Tamk1s/SSM/Common Rsrsc/SetupPics/CRT.jpg

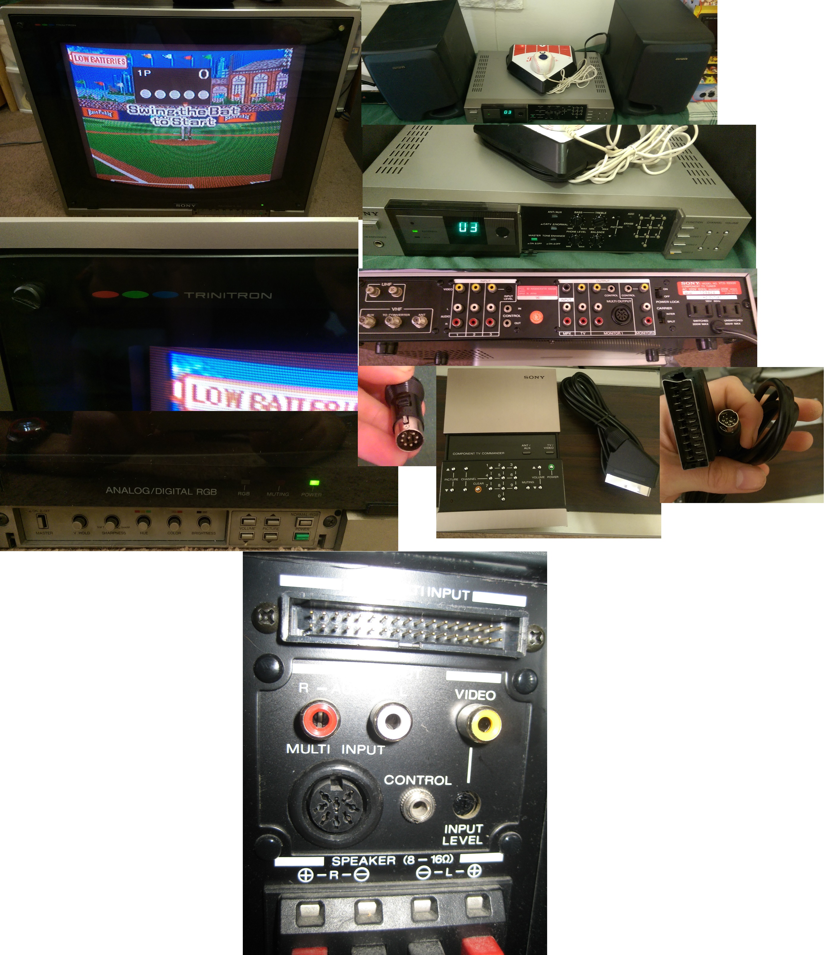
Common Rsrsc/SetupPics/CRT.jpg
