Tamk1s/SSM/SSMX_RGB/Resources/switcher_diagram_engadget_howto.jpg

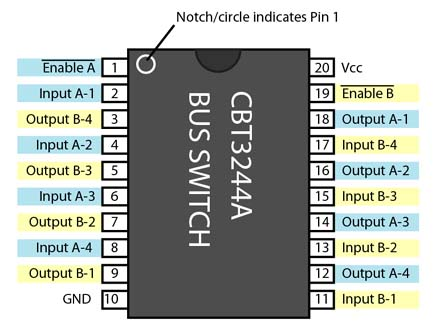
SSMX_RGB/Resources/switcher_diagram_engadget_howto.jpg
