Tamk1s/SSM/Common Rsrsc/Links.txt

Basic info about RGB - http://retrorgb.com/rgbintro.html

Base schematic info:
SCART -> IDC34 = https://wavebeam.blogspot.com/2017/08/making-scart-adapter-for-sony-34-pin.html
BNC -> IDC34 = https://www.reddit.com/r/crtgaming/comments/85gxof/sony_profeel_34_pin_rgb_cable_success/dw0ljwp/ and https://imgur.com/gallery/XTBUQ
S-Video -> SCART = https://pinouts.ru/Audio-Video-Hardware/scart_adapter_pinout.shtml
S-Video pinout = https://what-when-how.com/display-interfaces/standards-for-analog-video-part-i-television-display-interfaces-part-3/

Schematic info:

Bus Switcher - https://www.engadget.com/2007/03/13/how-to-make-a-solid-state-a-v-switcher/
Bus Switcher 2 - https://forums.overclockers.com.au/threads/solid-state-av-switcher.608891/
SCART Breakout - https://oshpark.com/shared_projects/X2S30KLq

Pullup Resistor info - https://learn.sparkfun.com/tutorials/pull-up-resistors

Eagle Symbols:
IDC34 - http://www.diymodules.org/eagle-show-library?type=usr&id=1012211566&part=con-3m-skt-header.lbr
SCART - https://www.diymodules.org/eagle-show-object?type=std&file=con-hirschmann.lbr&device=SCART-F
Switches - https://github.com/zumbik/Eagle-Libraries/blob/master/gm/gm-switches.lbr
DC Jack symbol pins - https://electronics.stackexchange.com/questions/2381/deciphering-a-dc-jack-schematic
