Tamk1s/SSM/Artwork/geagle.png

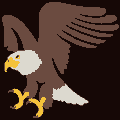
Artwork/geagle.png
