Tamk1s/SSM/Artwork/Large/p0m.bmp

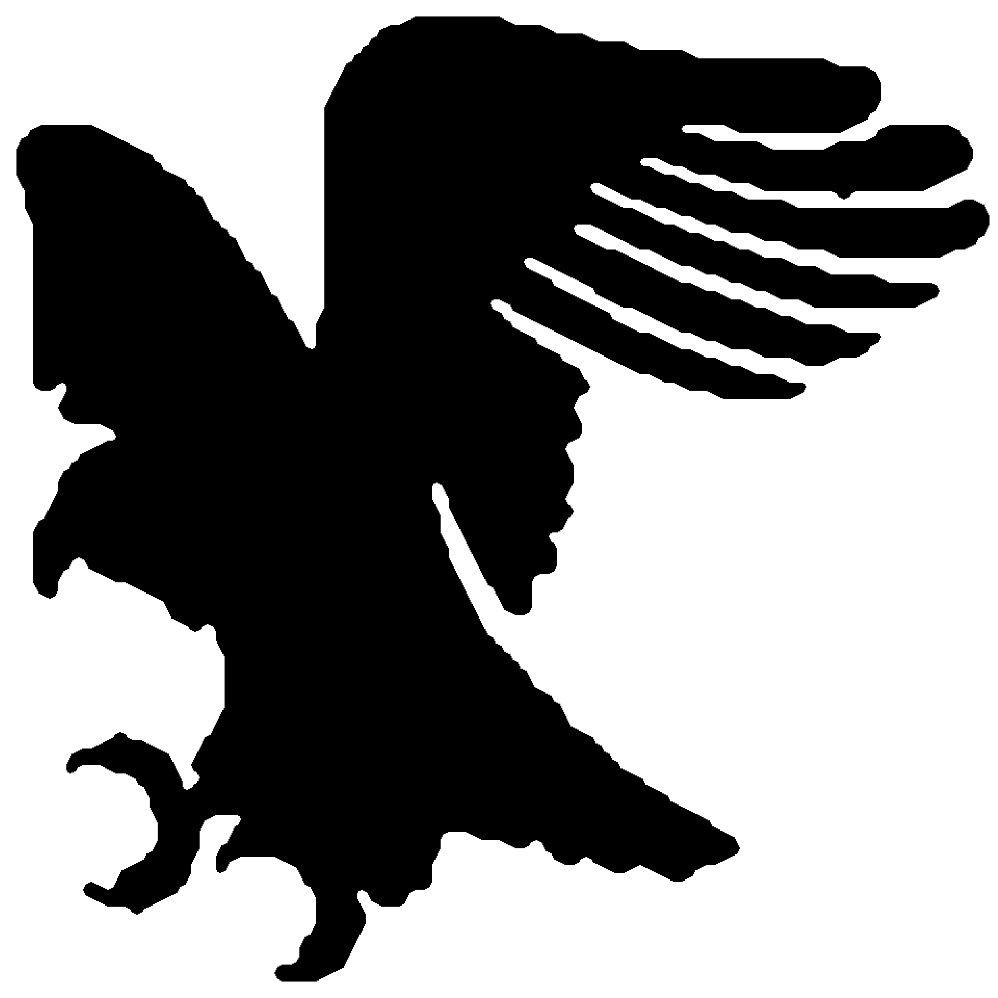
Artwork/Large/p0m.bmp
