Tamk1s/SSM/Artwork/Large/p1m.bmp

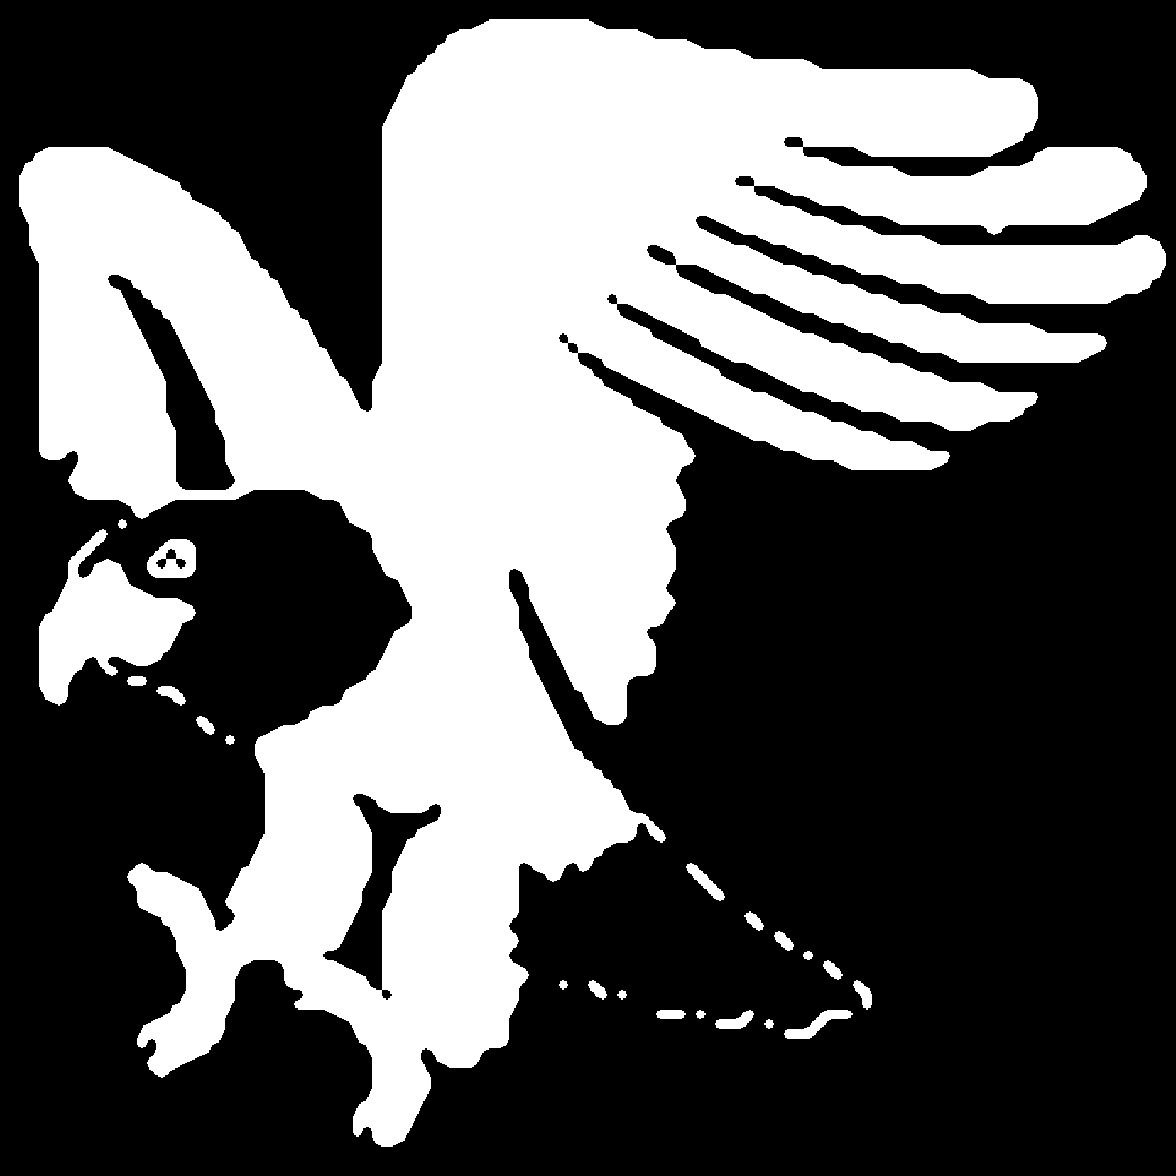
Artwork/Large/p1m.bmp
