Tamk1s/SSM/Artwork/Large/p2m.bmp

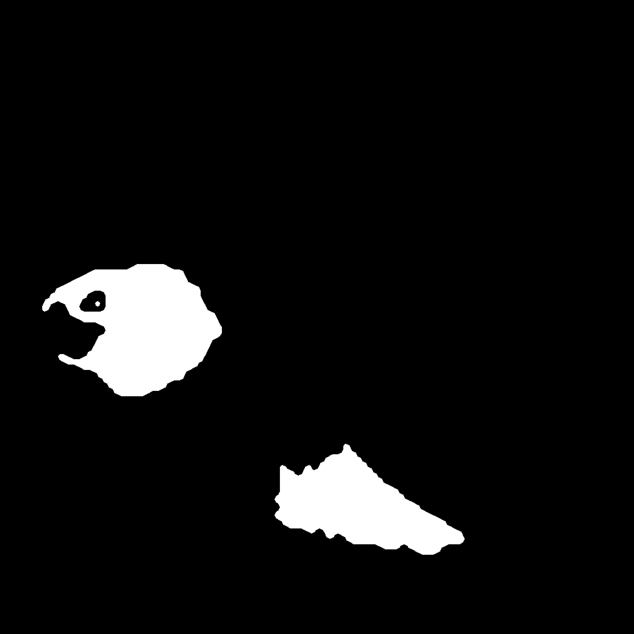
Artwork/Large/p2m.bmp
