Tamk1s/SSM/Artwork/Large/p3m.bmp

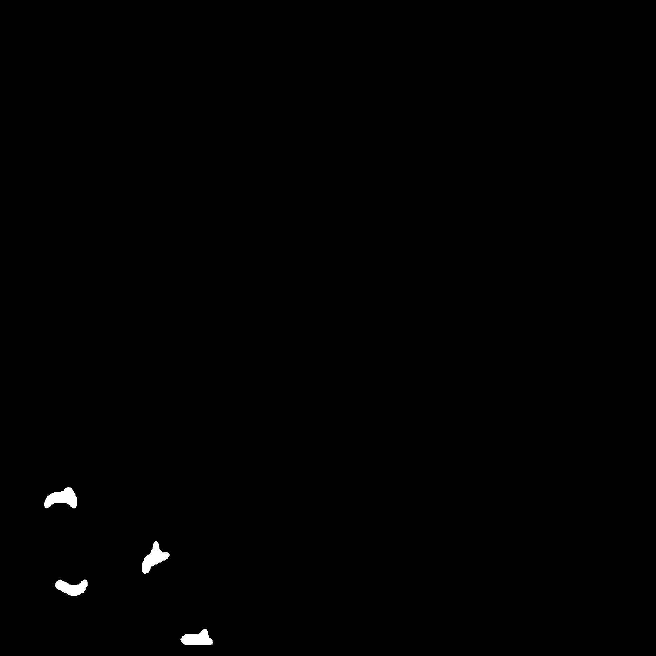
Artwork/Large/p3m.bmp
