Tamk1s/SSM/Common Rsrsc/S-Video.png

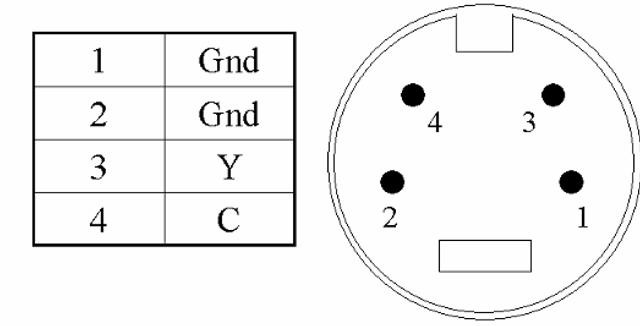
Common Rsrsc/S-Video.png
