Tamk1s/SSM/Common Rsrsc/SCART_Pinout.png

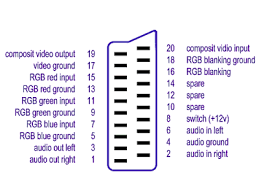
Common Rsrsc/SCART_Pinout.png
