Tamk1s/SSM/Common Rsrsc/Std_IDC34_Pinout.png

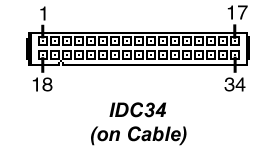
Common Rsrsc/Std_IDC34_Pinout.png
