Tamk1s/SSM/Common Rsrsc/BOM.pdf

Copyright © 1995-2018, Digi-Key Electronics. All Rights Reserved.
701 Brooks Avenue South,

## Cart Tools

## Input

New Cart - create a new empty cart Fast Add - bulk add multiple part numbers to your cart
Add Carts - add previous carts
Add BOM - add existing BOMs
Add Quote - add previous Quotes Resume Cart - resume a previous cart Upload to Cart - upload a file, csv, txt, xls, xlsx

Upload to Cart

## Options

Update Stock Status - refresh the quantity available

## Output

Download - save a copy of your cart in spreadsheet format
Cart Share - create a new cart including only the quantity, part number, and customer reference

Cart Share

## Shopping Cart:

Web ID | 282334564 Access ID | 53096 Salesorder Number Uncommitted
Continue Shopping | Checkout

Questions? Give us a call at 1-800-344-4539 or chat with us now on .

Checkout Pricing is valid for this Web ID until 8/17/2018 if you place your order online.
Quantities are not reserved until the order has been submitted. | Continue Shopping
Quantity | Part Number | Customer Reference

All prices are in USD.
Index | Quantity | Image | Number Part | Description | Customer Reference | Available Quantity | Backorder Quantity | Unit Price | Extended Price
| | | | ND | CONN HEADER R/A 34POS GOLD | | 1 Immediate | 0 | 0.93000 | $0.93
| | | | | IC BUS SWITCH OCT 20-SOIC | | 4 Immediate | 0 | 0.60000 | $2.40
| | | | ND | CONN RCA JACK MONO 3.2MM R/A | | 2 Immediate | 0 | 0.73000 | $1.46
| | | | | CONN BNC JACK R/A 50 OHM PCB | | 5 Immediate | 0 | 3.31000 | $16.55
| | | | ND | RES 10K OHM 1/4W 5% AXIAL | | 4 Immediate | 0 | 0.10000 | $0.40
| | | | ND | CONN PWR JACK 2X5.5MM SOLDER | | 1 Immediate | 0 | 0.64000 | $0.64
| | | | ND | SWITCH TOGGLE SPDT 6A 125V | | 1 Immediate | 0 | 4.86000 | $4.86
| | | | ND | SWITCH SLIDE SPDT 300MA 125V | | 1 Immediate | 0 | 1.55000 | $1.55
| | | | | IC REG LINEAR 5V 1.5A TO220AB | | 1 Immediate | 0 | 0.50000 | $0.50
1 | ED10540-
2 | 1727-3580- ND
3 | CP-1466-
4 | A97569-ND
5 | 10KQBK-
6 | CP-102A-
7 | 679-2466-
8 | 450-1609-
9 | 497-1443-5-
ND
Subtotal | $29.29
Shipping | Estimate
Sales Tax | unknown
Total | unknown

Are you shipping outside the United States?

Information: Please refer to our Terms and Conditions and Privacy Statement.

Online Ordering | Digi-Key | https://www.digikey.com/classic/Ordering/AddPart.aspx?lang=en
1 of 2 | 07/18/18, 10:59 PM

Thief River Falls, MN 56701 USA

Online Ordering | Digi-Key | https://www.digikey.com/classic/Ordering/AddPart.aspx?lang=en
2 of 2 | 07/18/18, 10:59 PM
