Tamk1s/SSM/Common Rsrsc/Bom.xls

Sony Super Multi (X) BOM
Product Models | Info |  | Part Number |  | Digikey Part info |  | Alt Info | Qty | Digikey Pricing |  |  |  |  |  |  |  | Alt Pricing |  | Unit Difference | Total Price difference
 | Index | Human Desc | Digikey | Alt | Description | Link | Link |  | Unit Price USD |  |  |  |  |  | Total Price |  | Unit Price USD | Total Price
 |  |  |  |  |  |  |  |  | Unit | At 10 | At 20 | At 40 | At 50 | At 100 | SSM (x20 batch) | SSMX (x10 batch)
SSM+SSMX | 1 | IDC34 Jack | ED10540-ND |  | CONN HEADER R/A 34POS GOLD | Link (https://www.digikey.com/short/j5bz3p) |  | 1 | $0.93 | $0.82 | $0.82 |  |  |  | $0.82 | $0.82 |  |  |  |  | 10 | 20
SSMX | 2 | Bus Switch IC | 1727-3580-ND |  | IC BUS SWITCH OCT 20-SOIC | https://www.digikey.com/short/j5bz3p |  | 4 | $0.60 |  |  | $0.50 |  |  |  | $2.00 |  |  |  |  | 40
SSM+SSMX | 3 | RCA Jack | CP-1466-ND |  | CONN RCA JACK MONO 3.2MM R/A | https://www.digikey.com/short/j5bz3p |  | 2 | $0.73 |  | $0.60 | $0.60 |  |  | $1.20 | $1.20 |  |  |  |  | 20 | 40
SSM+SSMX | 4 | BNC Jacks | A97569-ND | 5-1634513-1 | CONN BNC JACK R/A 50 OHM PCB | https://www.digikey.com/short/j5bz3p | eBay (https://www.sager.com/5-1634513-1-1202204.html) | 5 | $3.40 |  |  |  | $2.95 | $2.81 | $14.05 | $14.75 | $0.97 | $4.85 | $2.43 | $9.20 | 50 | 100
SSMX | 5 | 10kOhm Resistor | 10KQBK-ND |  | RES 10K OHM 1/4W 5% AXIAL | https://www.digikey.com/short/j5bz3p |  | 4 | $0.10 |  |  |  | $0.32 |  |  | $1.28 |  |  |  |  | 40
SSMX | 6 | Power Jack | CP-102A-ND |  | CONN PWR JACK 2X5.5MM SOLDER | https://www.digikey.com/short/j5bz3p |  | 1 | $0.64 | $0.60 |  |  |  |  |  | $0.60 |  |  |  |  | 10
SSMX | 7 | Power Sw Toggle | 679-2466-ND |  | SWITCH TOGGLE SPDT 6A 125V | https://www.digikey.com/short/j5bz3p |  | 1 | $4.86 | $4.63 |  |  |  |  |  | $4.63 |  |  |  |  | 10
SSMX | 8 | AV Sw Slide | 450-1609-ND |  | SWITCH SLIDE SPDT 300MA 125V | https://www.digikey.com/short/j5bz3p |  | 1 | $1.55 | $1.49 |  |  |  |  |  | $1.49 |  |  |  |  | 10
SSMX | 9 | 7805 Voltage Regulator | 497-1443-5-ND |  | IC REG LINEAR 5V 1.5A TO220AB | https://www.digikey.com/short/j5bz3p |  | 1 | $0.50 | $0.50 |  |  |  |  |  | $0.50 |  |  |  |  | 10
SSM+SSMX | 10 | SCART Right Angle Jack |  | eBay | BRAND-NEW 90° SCART SOCKETS FOR PCB MOUNTING PACK OF 5 WITH SCREW POSTS |  | eBay (https://www.ebay.com/itm/BRAND-NEW-90-SCART-SOCKETS-FOR-PCB-MOUNTING-PACK-OF-5-WITH-SCREW-POSTS/320587049713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) | 1 |  |  |  |  |  |  |  |  | $1.49 | $1.49
SSM+SSMX | 11 | Twisted Floppy Cable |  | eBay | New 9" 34 Pin Single Drive Floppy Ribbon Cable 3.5" and 5.25" FDD |  | eBay (https://www.ebay.com/itm/New-9-34-Pin-Single-Drive-Floppy-Ribbon-Cable-3-5-and-5-25-FDD/252281345525) | 1 |  |  |  |  |  |  |  |  | $3.70 | $3.70
SSM+SSMX | 12 | Advantus Corp Stacker Crayon Box |  | WalMart |  |  | WalMart (https://www.walmart.com/ip/Advantus-Corp-Stackable-Crayon-Box/32962001) | 1 |  |  |  |  |  |  |  |  | $0.68 | $0.68
SSMX | 13 | 9V 1A 2.1mm Power Supply |  | eBay |  |  | eBay (https://www.ebay.com/itm/5-5x2-1mm-AC-to-DC-9V-1A-Converter-Charger-Adapter-Power-Supply-650-mA-Cord-US/162753492985) | 1 |  |  |  |  |  |  |  |  | $5.29 | $5.29
Packaging costs
Product Model | Item | Desc | Item link | Qty | Unit Price USD | Total Price USD
SSM | Comp bag | Bag for component org (3x5 q100) | eBay (https://www.ebay.com/itm/25-1000-2-mil-Ziplock-Large-Small-Zip-Lock-Jewelry-Bags-Reclosable-Zipper-bags/111315261621) | 2 | $0.05 | $0.10
SSM+SSMX | SSM Kit bag | Hold entire kit contents (5x8 q100) | eBay (https://www.ebay.com/itm/Ziplock-3ML-Food-Parts-Storage-bags-3Mil-Clear-Freezer-Large-Small-Baggies/111663235317) | 1 | $0.10 | $0.10
SSMX | Anti static bag | Used for Bus Switcher IC/Vreg (3x5 q100) | eBay (https://www.ebay.com/itm/25-50-100-500-1000-Pink-Antistatic-Ziplock-Bags-4Mil-Heavy-Duty-Reclosable-PAS/111252005561) | 1 | $0.07 | $0.07
SSMX | Comp bag | Bag for component org (3x5 q100) | eBay (https://www.ebay.com/itm/25-1000-2-mil-Ziplock-Large-Small-Zip-Lock-Jewelry-Bags-Reclosable-Zipper-bags/111315261621) | 2 | $0.05 | $0.10
SSM+SSMX | Kraft Duck 6"x9" Buble Mailers | Mailing envelope | WalMart (https://www.walmart.com/ip/Duck-Kraft-Bubble-Mailers-0-6-In-x-9-in-Self-Sealing-12-Count/116657010) | 1 | $0.39 | $0.39
Total Costs | Model | Pkg cost | Pkg shipping | Total
 | SSM | $0.58 | $3.75 | $4.33
 | SSMX | $0.66 | $3.75 | $4.41
Cost Totals
Model | BOM Costs |  |  | PCB Costs |  |  | Kit packaging costs |  |  |  |  | Total costs
 |  |  |  |  |  |  | Kit packaging+ship | Pre-assembly | Kit making fee | Total Kit packaging costs |  | W/o preasm | W preasm
 | BOM Cost | BOM Shipping | BOM Total | PCB Cost | PCB Shipping | PCB Total |  |  |  | W/o asm | W asm
SSM | $12.74 | $3.75 | $16.49 | $8.60 | $0.00 | $8.60 | $4.33 | $5.00 | $5.00 | $9.33 | $14.33 | $34.42 | $39.42
SSMX | $28.53 | $3.75 | $32.28 | $11.18 | $0.00 | $11.18 | $4.41 | $5.00 | $5.00 | $9.41 | $14.41 | $52.87 | $57.87
Cost Diff | $15.79 | $0.00 | $15.79 | $2.58 | $0.00 | $2.58 | $0.07 | $0.00 | $0.00 | $0.07 | $0.07 | $18.45 | $18.45
