Tamk1s/SSM/Common Rsrsc/SetupPics/_v2.png

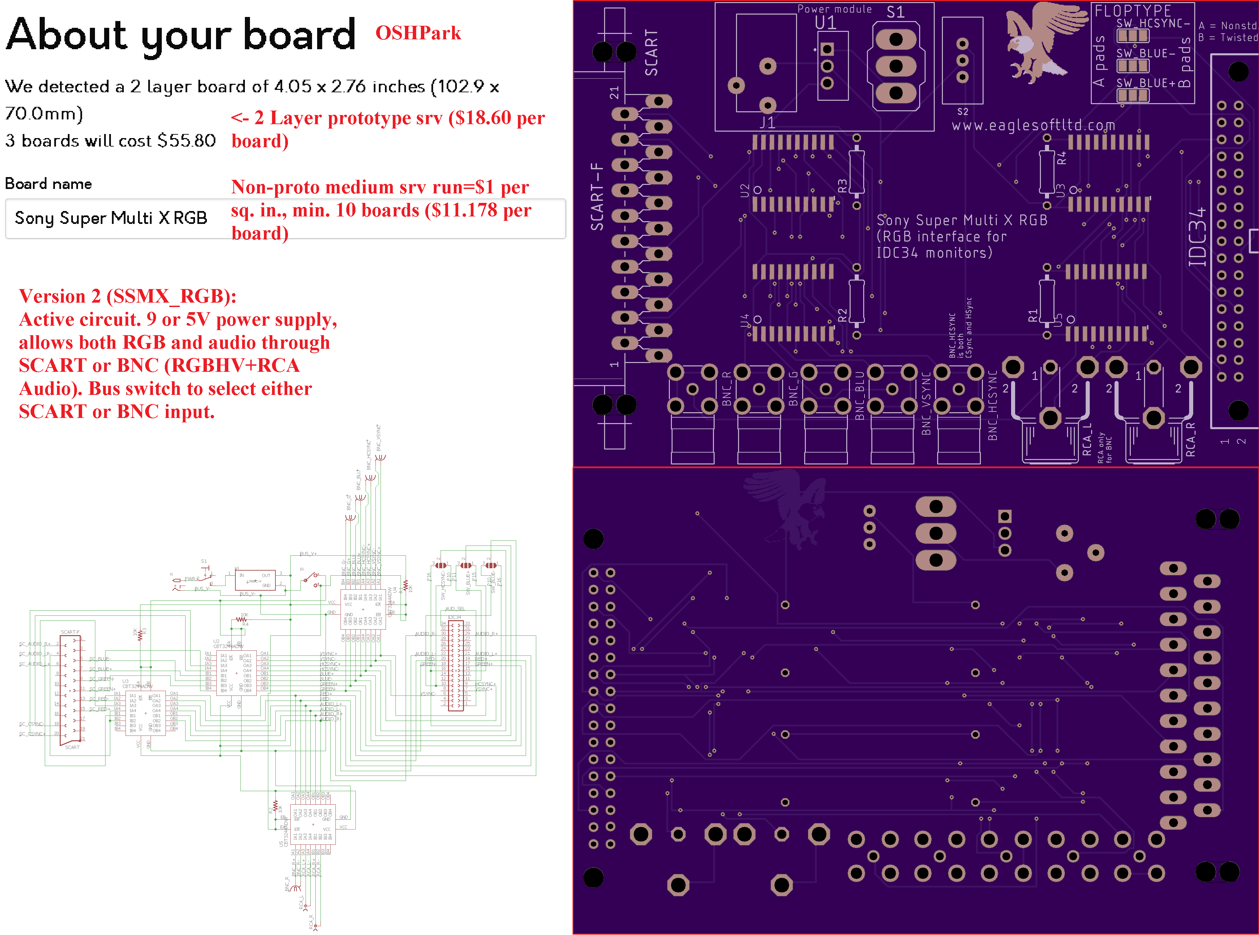
Common Rsrsc/SetupPics/_v2.png
