Tamk1s/SSM/Common Rsrsc/SetupPics/v0.jpg

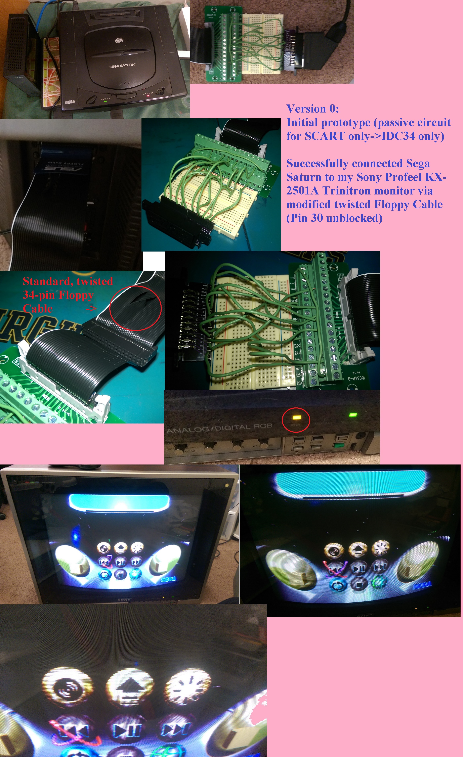
Common Rsrsc/SetupPics/v0.jpg
