Tamk1s/SSM/Common Rsrsc/WaveBeam_CircuitModWiring/IDC34.jpg

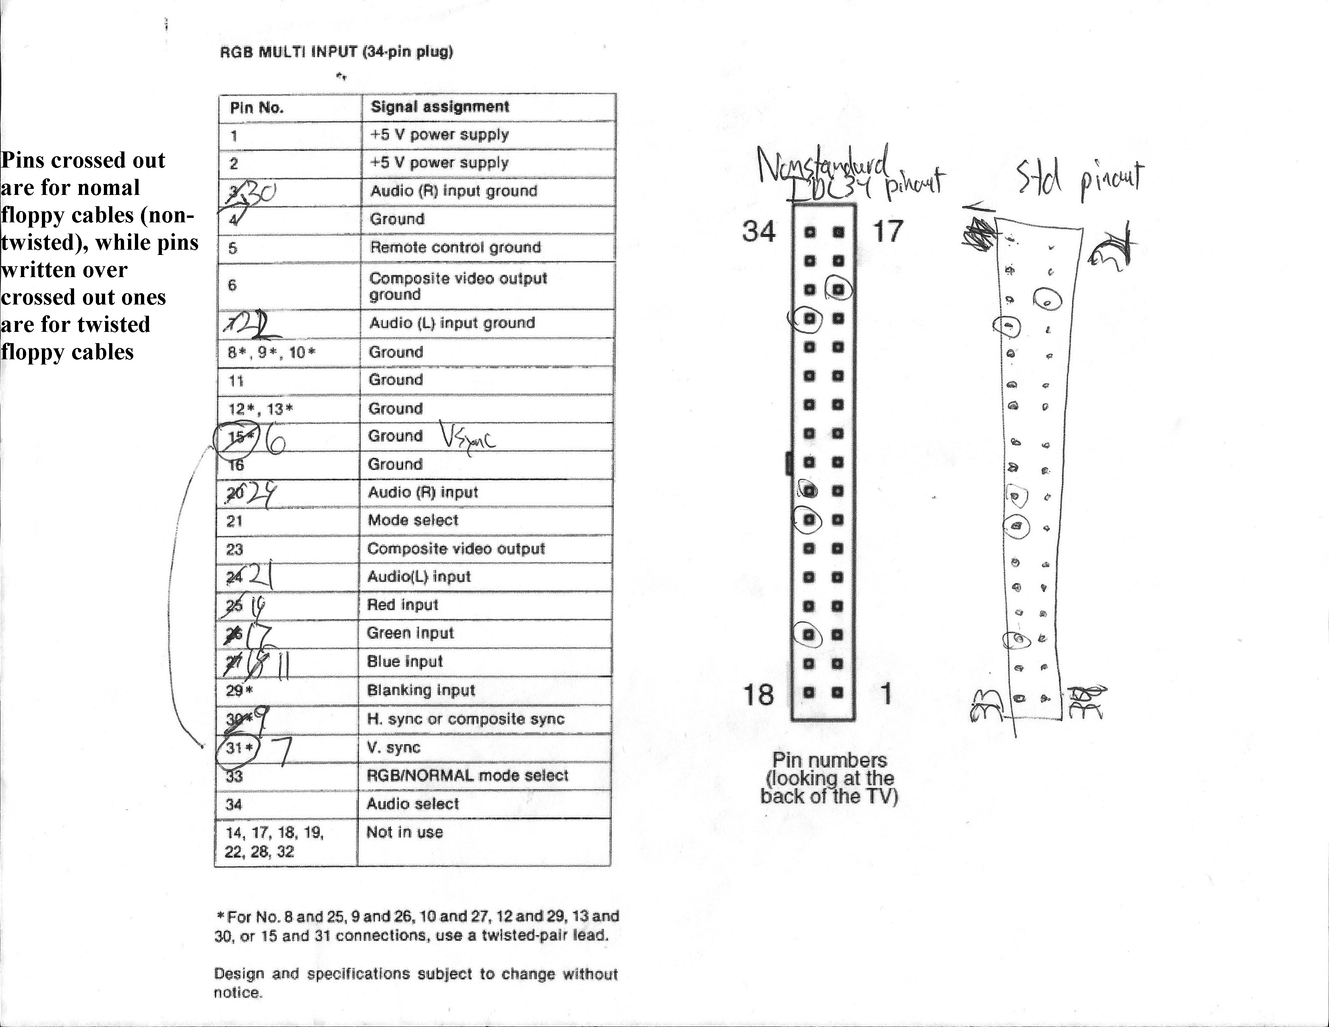
Common Rsrsc/WaveBeam_CircuitModWiring/IDC34.jpg
