Tamk1s/SSM/Common Rsrsc/WaveBeam_CircuitModWiring/SCART_BNC_to_IDC34.jpg

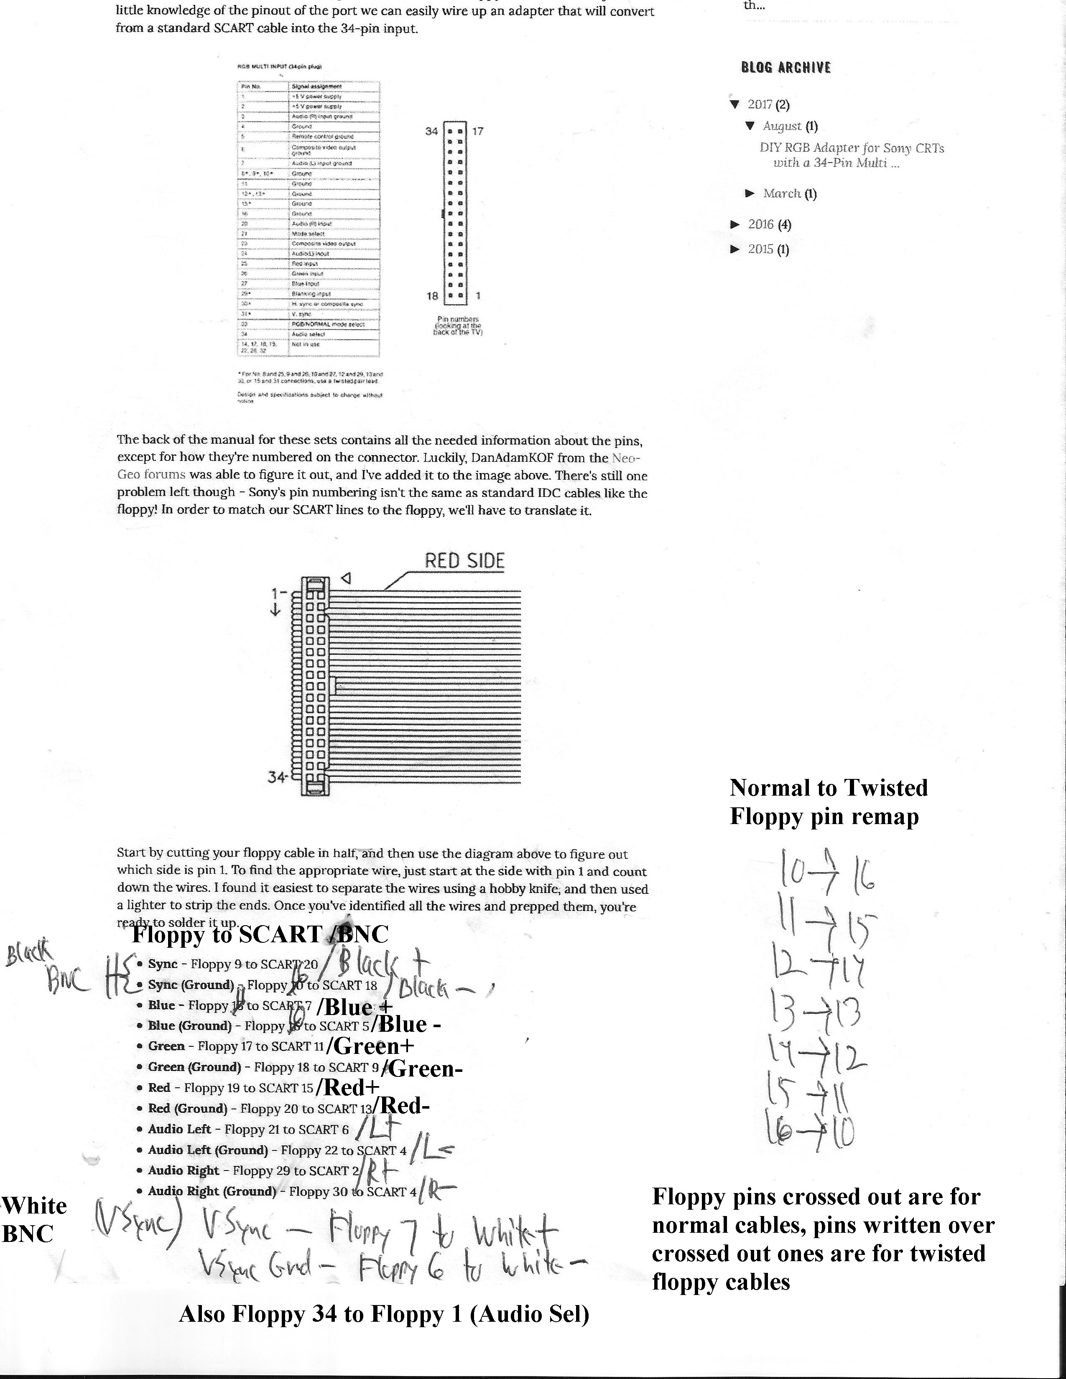
Common Rsrsc/WaveBeam_CircuitModWiring/SCART_BNC_to_IDC34.jpg
