Tamk1s/SSM/Artwork/ColorPalTest.png

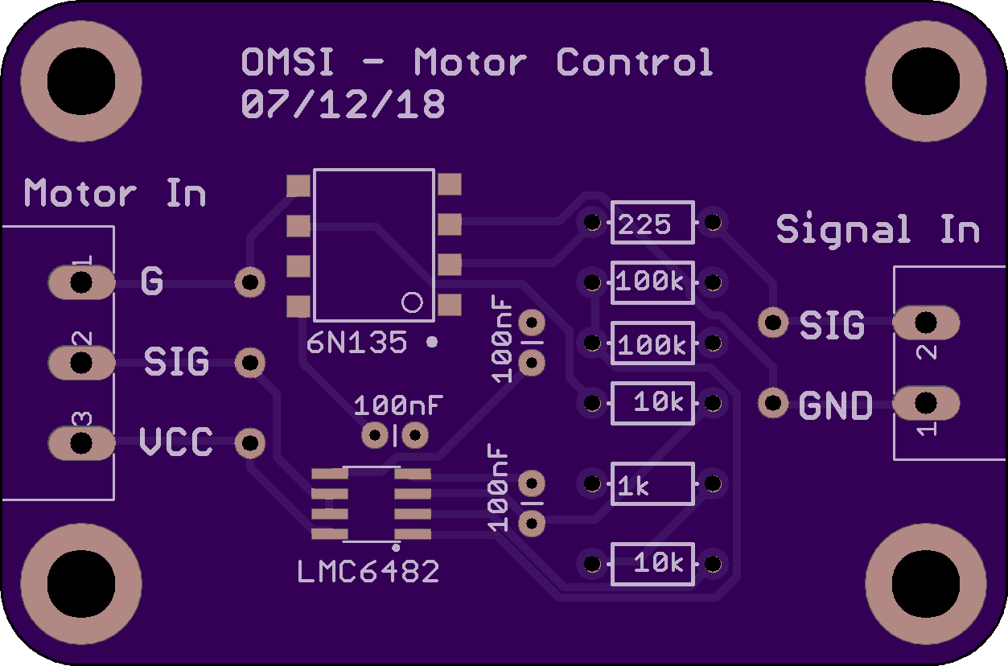
Artwork/ColorPalTest.png
