Tamk1s/SSM/SSMX_RGB/SSM_RGB.brd

## EAGLE design SSMX_RGB/SSM_RGB.brd (2018-08-31)

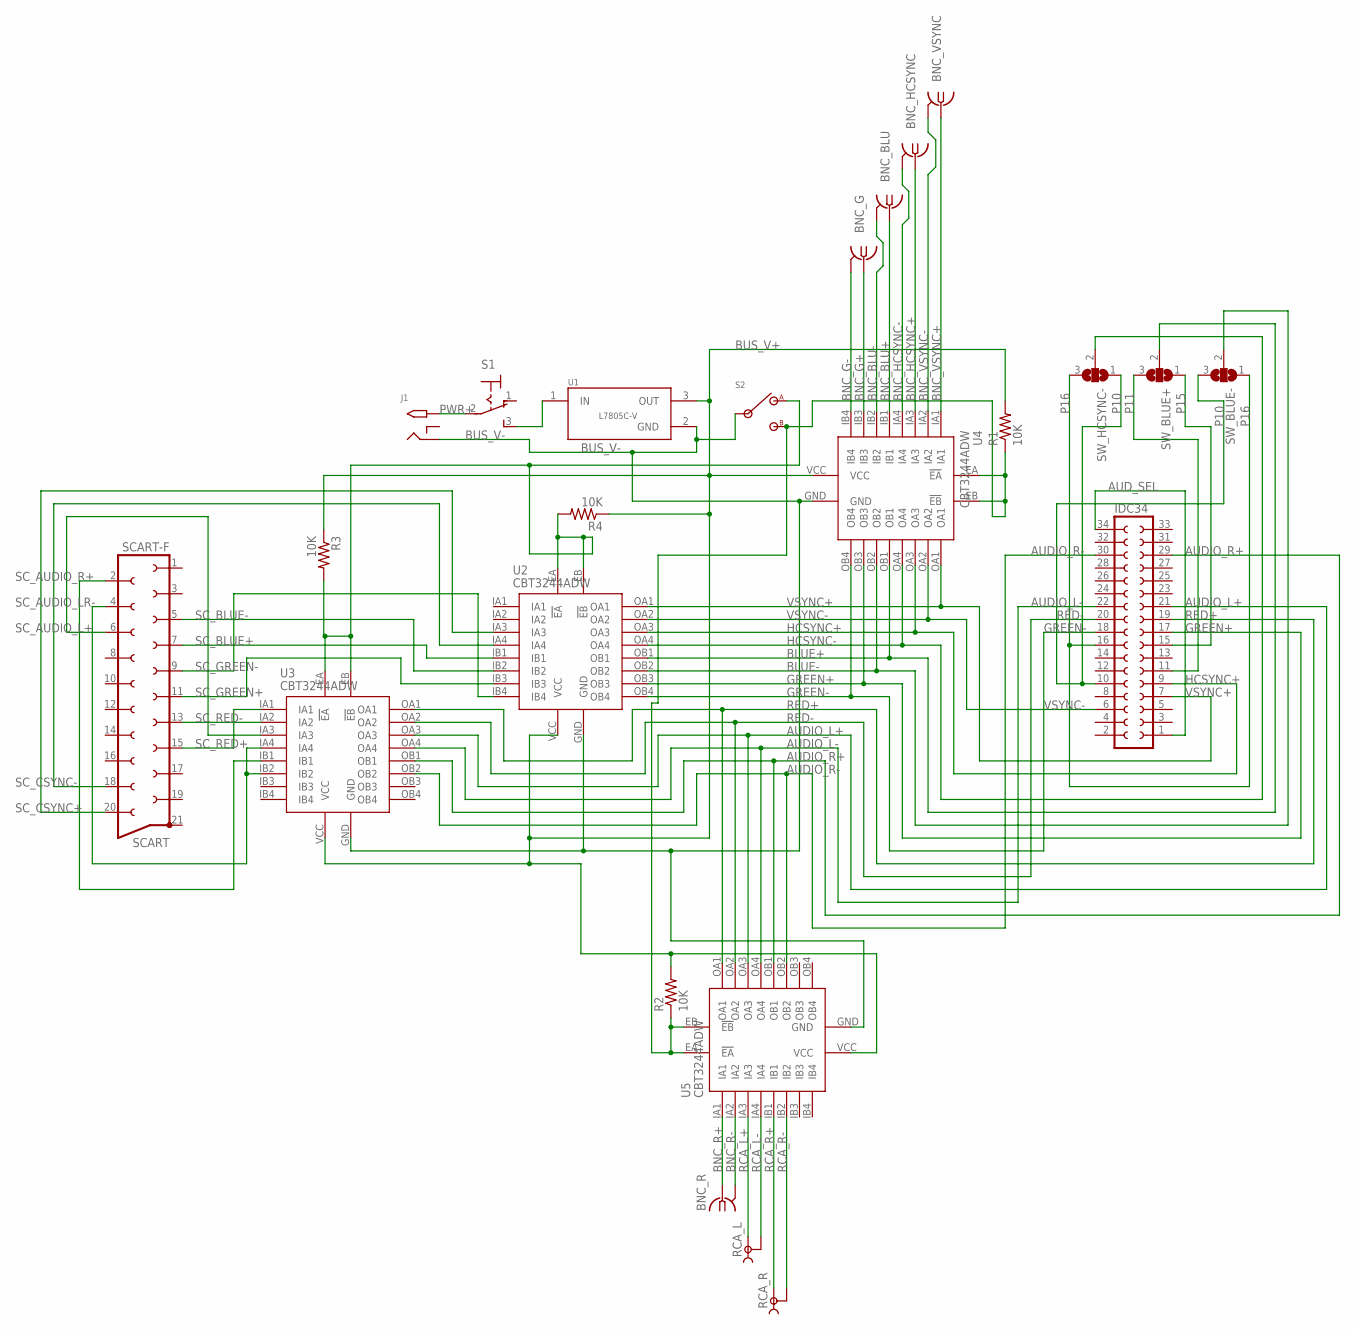
[picture p16: schematic SSM_RGB.sch]

Parts:
BNC_BLU: 142142
BNC_G: 142142
BNC_HCSYNC: 142142
BNC_R: 142142
BNC_VSYNC: 142142
IDC34: SOCKET-34RA; S34RA
J1: 2.1MMJACKTHM; PJ-102A
R1, R2, R3, R4: 10K; 0207/10
RCA_L: TOBU3
RCA_R: TOBU3
S1: 320-916
S2: STS121PC04
SCART: SCART-F
SW_BLUE+: SJ2W; SJ_2
SW_BLUE-: SJ2W; SJ_2
SW_HCSYNC-: SJ2W; SJ_2
U1: L7805C-V; TO254P460X1020X1945-3P
U2, U3, U4, U5: CBT3244ADW; SOIC-20

Connections:
AUDIO_L+: IDC34.21, U3.OA3, U5.OA3
AUDIO_L-: IDC34.22, U3.OA4, U5.OA4
AUDIO_R+: IDC34.29, U3.OB1, U5.OB1
AUDIO_R-: IDC34.30, U3.OB2, U5.OB2
AUD_SEL: IDC34.1, IDC34.34
BLUE+: SW_BLUE+.2, U2.OB1, U4.OB1
BLUE-: SW_BLUE-.2, U2.OB2, U4.OB2
BNC_BLU+: BNC_BLU.1, U4.IB1
BNC_BLU-: BNC_BLU.2, BNC_BLU.3 (2), BNC_BLU.4 (2), BNC_BLU.5 (2), U4.IB2
BNC_G+: BNC_G.1, U4.IB3
BNC_G-: BNC_G.2, BNC_G.3 (2), BNC_G.4 (2), BNC_G.5 (2), U4.IB4
BNC_HCSYNC+: BNC_HCSYNC.1, U4.IA3
BNC_HCSYNC-: BNC_HCSYNC.2, BNC_HCSYNC.3 (2), BNC_HCSYNC.4 (2), BNC_HCSYNC.5 (2), U4.IA4
BNC_R+: BNC_R.1, U5.IA1
BNC_R-: BNC_R.2, BNC_R.3 (2), BNC_R.4 (2), BNC_R.5 (2), U5.IA2
BNC_VSYNC+: BNC_VSYNC.1, U4.IA1
BNC_VSYNC-: BNC_VSYNC.2, BNC_VSYNC.3 (2), BNC_VSYNC.4 (2), BNC_VSYNC.5 (2), U4.IA2
BUS_V+: R1.2, R2.2, R3.1, R4.1, U1.3 (OUT), U2.VCC, U3.VCC, U4.VCC, U5.VCC
BUS_V-: J1.RING, S2.2, U1.2 (GND), U2.GND, U3.GND, U4.GND, U5.GND
GREEN+: IDC34.17, U2.OB3, U4.OB3
GREEN-: IDC34.18, U2.OB4, U4.OB4
HCSYNC+: IDC34.9, U2.OA3, U4.OA3
HCSYNC-: SW_HCSYNC-.2, U2.OA4, U4.OA4
unnamed: R1.1, R2.1, S2.3, U4.EA (!EA), U4.EB (!EB), U5.EA (!EA), U5.EB (!EB)
unnamed: S1.3 (S), U1.1 (IN)
unnamed: R3.2, R4.2, S2.1, U2.EA (!EA), U2.EB (!EB), U3.EA (!EA), U3.EB (!EB)
P10: IDC34.10, SW_BLUE-.3, SW_HCSYNC-.1
P11: IDC34.11, SW_BLUE+.3
P15: IDC34.15, SW_BLUE+.1
P16: IDC34.16, SW_BLUE-.1, SW_HCSYNC-.3
PWR+: J1.TIP, S1.2
RCA_L+: RCA_L.1, U5.IA3
RCA_L-: RCA_L.2, RCA_L.2@1 (2), RCA_L.2@2 (2), U5.IA4
RCA_R+: RCA_R.1, U5.IB1
RCA_R-: RCA_R.2, RCA_R.2@1 (2), RCA_R.2@2 (2), U5.IB2
RED+: IDC34.19, U3.OA1, U5.OA1
RED-: IDC34.20, U3.OA2, U5.OA2
SC_AUDIO_L+: SCART.6, U3.IA3
SC_AUDIO_LR-: SCART.4, U3.IA4, U3.IB2
SC_AUDIO_R+: SCART.2, U3.IB1
SC_BLUE+: SCART.7, U2.IB1
SC_BLUE-: SCART.5, U2.IB2
SC_CSYNC+: SCART.20, U2.IA3
SC_CSYNC-: SCART.18, U2.IA4
SC_GREEN+: SCART.11, U2.IB3
SC_GREEN-: SCART.9, U2.IB4
SC_RED+: SCART.15, U3.IA1
SC_RED-: SCART.13, U3.IA2
VSYNC+: IDC34.7, U2.OA1, U4.OA1
VSYNC-: IDC34.6, U2.OA2, U4.OA2

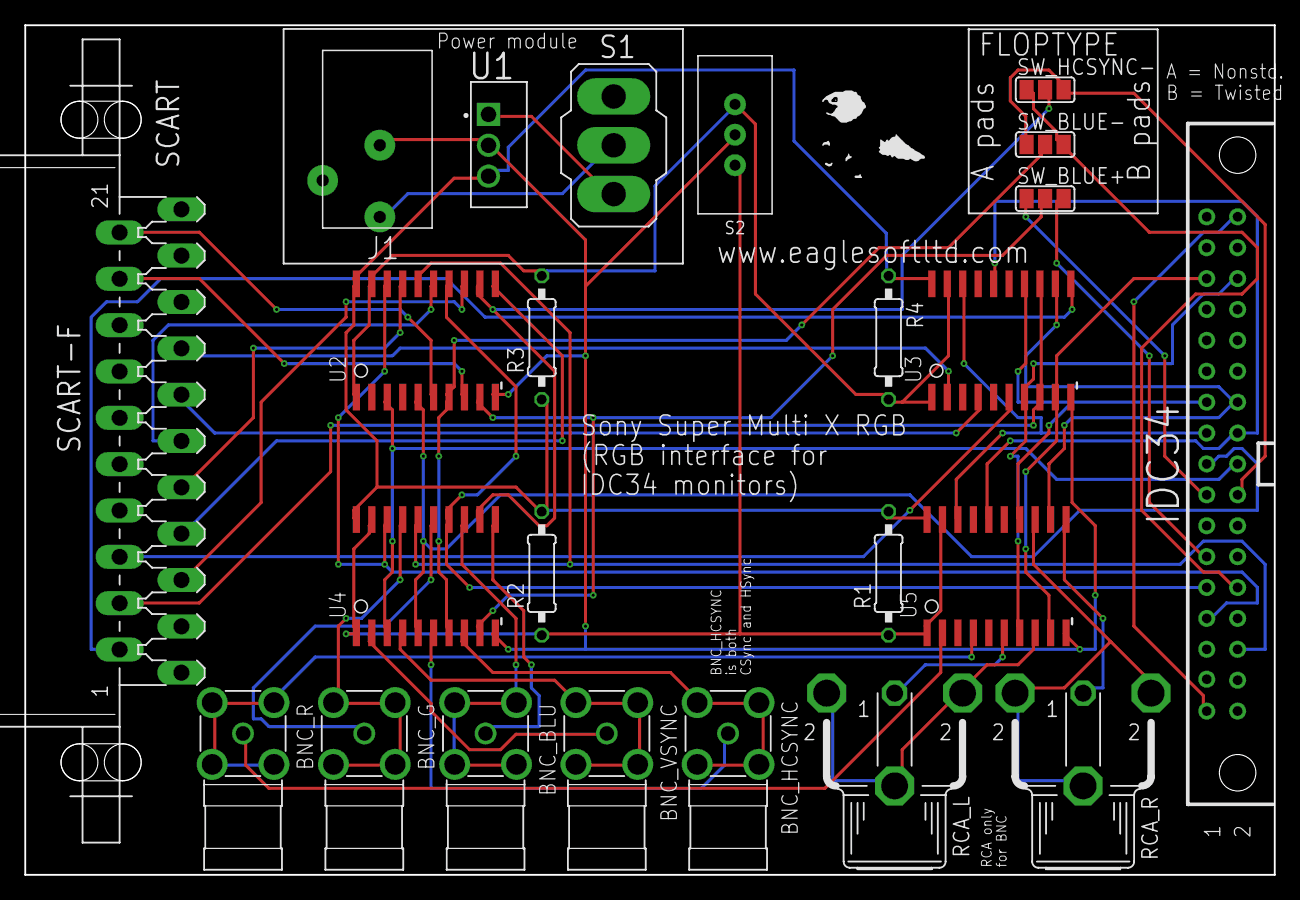
[picture p17: board SSMX_RGB/SSM_RGB.brd from above]

Board: 2 copper layers, 102.7 x 69.8 mm, 24 parts (0 on the bottom side), 50 nets.
