Tamk1s/SSM/SSM_RGB/SSM_RGB.brd

## EAGLE design SSM_RGB/SSM_RGB.brd (2018-08-30)

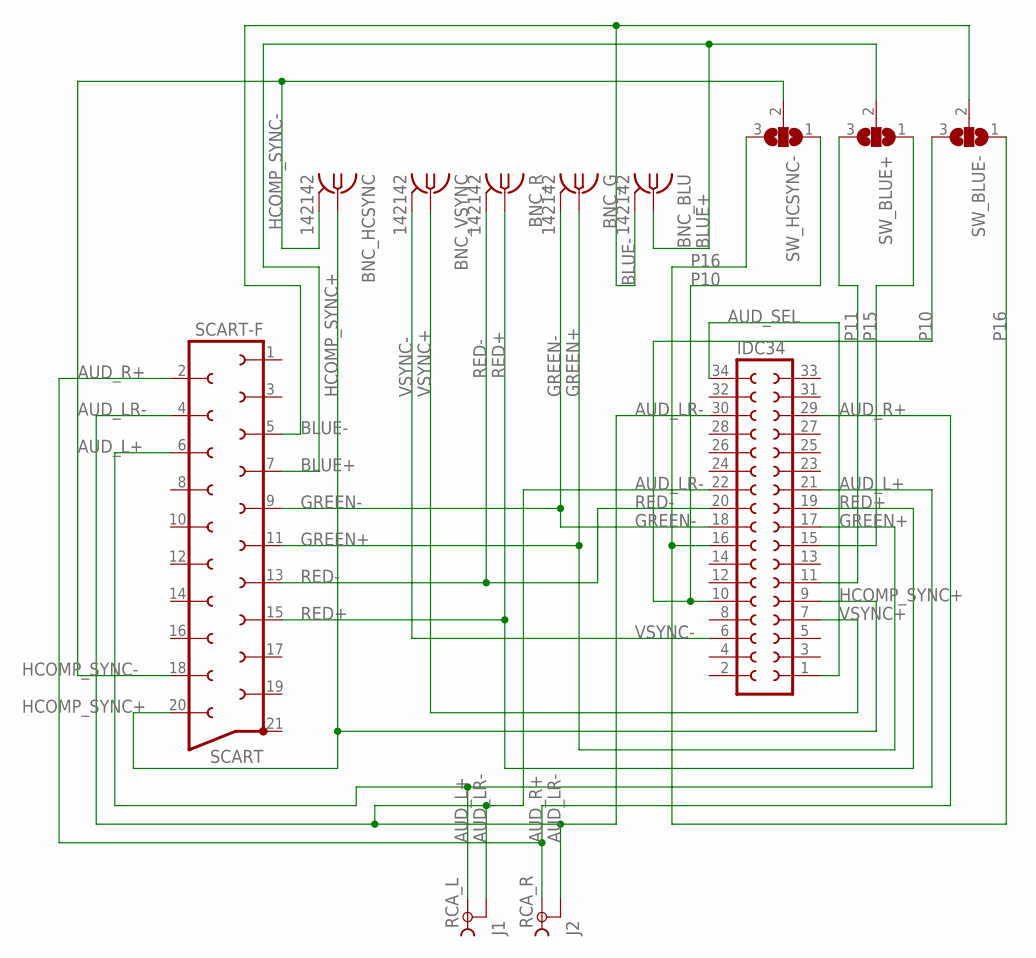
[picture p18: schematic SSM_RGB.sch]

Parts:
BNC_BLU: 142142
BNC_G: 142142
BNC_HCSYNC: 142142
BNC_R: 142142
BNC_VSYNC: 142142
IDC34: SOCKET-34RA; S34RA
RCA_L: J1; TOBU3
RCA_R: J2; TOBU3
SCART: SCART-F
SW_BLUE+: SJ2W; SJ_2
SW_BLUE-: SJ2W; SJ_2
SW_HCSYNC-: SJ2W; SJ_2

Connections:
AUD_L+: IDC34.21, RCA_L.1, SCART.6
AUD_LR-: IDC34.22, IDC34.30, RCA_L.2, RCA_L.2@1 (2), RCA_L.2@2 (2), RCA_R.2, RCA_R.2@1 (2), RCA_R.2@2 (2), SCART.4
AUD_R+: IDC34.29, RCA_R.1, SCART.2
AUD_SEL: IDC34.1, IDC34.34
BLUE+: BNC_BLU.1, SCART.7, SW_BLUE+.2
BLUE-: BNC_BLU.2, BNC_BLU.3 (2), BNC_BLU.4 (2), BNC_BLU.5 (2), SCART.5, SW_BLUE-.2
GREEN+: BNC_G.1, IDC34.17, SCART.11
GREEN-: BNC_G.2, BNC_G.3 (2), BNC_G.4 (2), BNC_G.5 (2), IDC34.18, SCART.9
HCOMP_SYNC+: BNC_HCSYNC.1, IDC34.9, SCART.20
HCOMP_SYNC-: BNC_HCSYNC.2, BNC_HCSYNC.3 (2), BNC_HCSYNC.4 (2), BNC_HCSYNC.5 (2), SCART.18, SW_HCSYNC-.2
P10: IDC34.10, SW_BLUE-.3, SW_HCSYNC-.1
P11: IDC34.11, SW_BLUE+.3
P15: IDC34.15, SW_BLUE+.1
P16: IDC34.16, SW_BLUE-.1, SW_HCSYNC-.3
RED+: BNC_R.1, IDC34.19, SCART.15
RED-: BNC_R.2, BNC_R.3 (2), BNC_R.4 (2), BNC_R.5 (2), IDC34.20, SCART.13
VSYNC+: BNC_VSYNC.1, IDC34.7
VSYNC-: BNC_VSYNC.2, BNC_VSYNC.3 (2), BNC_VSYNC.4 (2), BNC_VSYNC.5 (2), IDC34.6

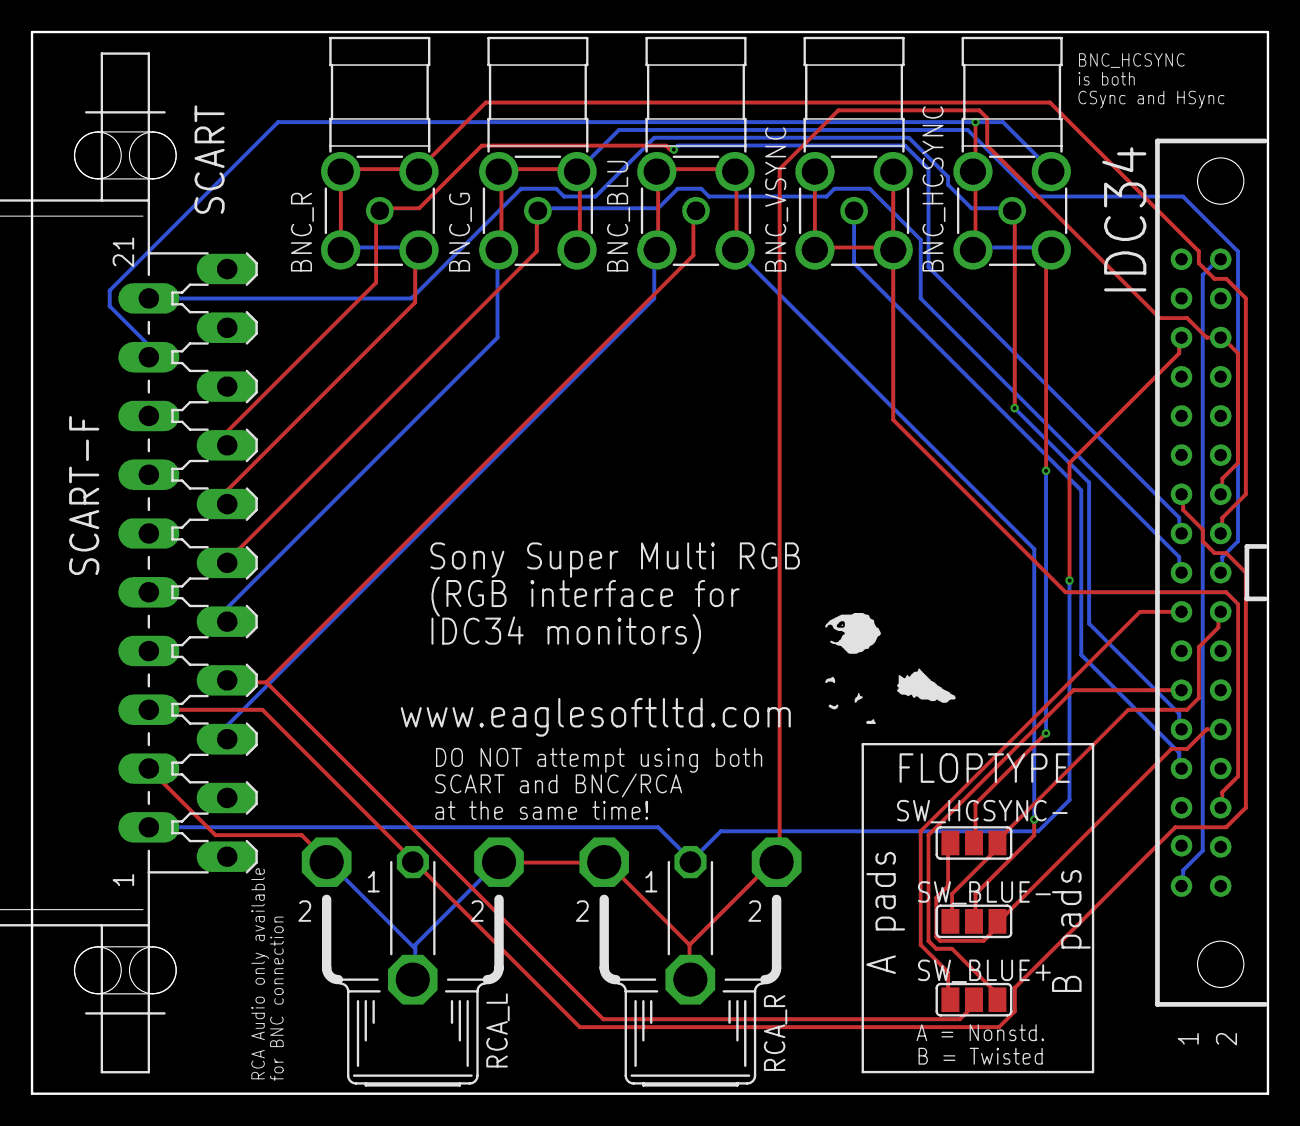
[picture p19: board SSM_RGB/SSM_RGB.brd from above]

Board: 2 copper layers, 80.1 x 68.8 mm, 12 parts (0 on the bottom side), 18 nets.
