Tamk1s/SSM/(commit log)

2018-07-29 Clarification for normal vs. twisted floppy mapping
    [Bom.xls]
2018-08-03 Updated logo
    *Fixed bug with logo not appearing with proper colors. (Made beak and brown wings copper gold)
    [Bom.xls, SSM_RGB.brd]
2018-08-13 Revision
    *Tied S_PWR Pos 1 to nothing (no power on this pos)
    *Addressed errors and warnings in ERC
    *Ran Autorouter again to fix netlist
    [SSM_RGB.brd, SSM_RGB.sch]
2018-08-30 Final PCB revisions
    SSM & X:
    *Renamed BNC_HComp_Sync to just BNC_HCSYNC
    *Renamed "Normal" cable type to "Nonstd"
    *Removed stray line segs in PCB Art
    SSM:
    *Added warning about using both AV sources
    X:
    *Renamed VReg and Bus Sw IC components to Ux series
    *Renamed both switchs to Sx series
    *Renamed "PWR" to "J1"
    Documentation:
    *1st draft. Needs final product photos/images, and list of component names+parts
    [Bom.xls, SSM_RGB.brd, SSM_RGB.sch]
2018-08-31 Updated pics, manual, BOM
    *Updated manuals with footprint names/labels for directions
    *Updated project artwork
    *Updated a trace on SSMX board, so that it doesn't go through copper-clad Eagle PCB
    *Updated BOM with more accurate, nearly final pricing. Added bagging costs. floppy cable costs
    [Bom.xls, SSM_RGB.brd]
2018-09-01 BOM update
    *Swapped out expensive x5 BNC pair from Digikey (~$18) with pricing based on a lot of 100 from eBay ($5 per kit)
    *Fixed typo in SSMX manual for header
    [Bom.xls]
2018-09-04 Updated BOM/manual
    [BOM.csv, Bom.xls]
2018-09-10 BOM Update
    Updated BOM costs with:
    *Package shipping
    *Crayon Box enclosure
    *Updated bagging costs
    [Bom.xls]
2019-12-25 Misc commit
    *Uploaded archive of pics
    *Updated Revisions Notes
    I need to implement changes in the revisions Notes doc, fabricated corrected prototype boards (correct footprints), fully test them, and finally release/sell these kits early this year !!
2022-02-05 Details about composite video revision
    - Added new links for S-Video<->SCART conversion (using those composite/S-Video<->SCART I/O adapters)
    - Added S-Video pinout link
    Details for these to be implemented in next revision of SSM(X) circuits, to tie 4 pins for S-Video/composite video support. This will allow Composite/S-Video<->SCART I/O adapters to work with the circuit.
    (Target/example usage case: CLD-D702 Laserdisc player S-Video support on this RGB monitor. S-Video utilizes 480p video on the LD player, allowing for higher resolution/RGB video on the player)
